jvegaf/Vumeter/README.md

# Vumeter

More info <a href="https://www.rinconingenieril.es/vumetro-por-etapas/"> https://www.rinconingenieril.es/vumetro-por-etapas/ </a>
