jvegaf/Vumeter/doc/Ingeniería/Ingeniería.odt

Display driver – Configuración

El uso del LM3915 exige el cálculo de dos resistencias encargadas de fijar la tensión de referencia del driver. La tensión de referencia controla la corriente de salida de cada canal (cada LED) y la tensión de referencia superior del driver.

El objetivo, no superar 15mA por canal y 3v de referencia. Se considera el uso de dos resistencias con valores: R_1 = 1 K %OMEGA y R_2 = 1 K %OMEGA

Según el fabricante y debido a la fuente de tensión constante de 1,25 v del circuito integrado, la tensión de referencia es:

V_REF = 1,25 \( 1 + {R_2} over {R_1} \) + R_2 · 80 %mu A V_REF = 2,58v

La corriente de cada canal es función de la tensión de referencia de la siguiente manera:

I_LED = {12,5} over {R_1} + {V_REF} over {2200}

Por tanto la corriente constante por canal es de 13,67 mA.

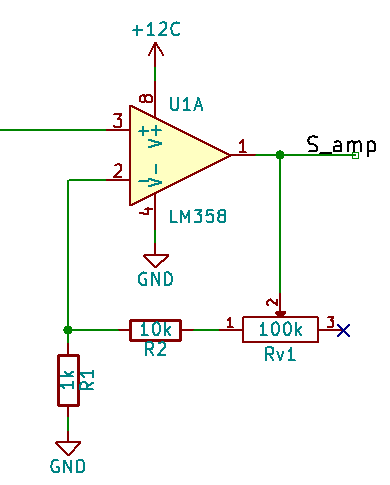
[picture p1: figure]

Amplificación

Debido a que la tensión de la señal de entrada puede ser desconocida, se procede a implementar una etapa de amplificación. Se decide usar el integrado LM358 por usar alimentación simple y contener dos amplificadores en el mismo encapsulado.

Considerando tensiones de pico de entrada comprendidas entre 25mV y 250mV y salida de Vref = 2,58 , la ganancia del amplificador no inversor deberá estar comprendida entre

G_max = {V_out} over {V rsup{min} rsub{i}} = { 2,58 } over { 0,025 } = 103,2

G_min = {V_out} over {V rsup{max} rsub{i}} = { 2,58 } over { 0,25 } = 10,32

Considerando la relación de ganancia de un amplificador en configuración no inversora, se fijan los valores de las resistencias R1, R2 y del potenciómetro Rv1.

G = 1 + {R_2 + Rv_1} over {R_1} R_1 = 1k %OMEGA R_2 = 10k %OMEGA Rv_1 = 100k %OMEGA

Filtrado de señal

Al tratarse de un dispositivo que representa de manera visual una señal de audio, se decide introducir la posibilidad de poder visualizar solo una zona del espectro audible (20 Hz a 20 Khz). Para esta tarea se decide establecer un sistema de filtros en cascada lo más sencillo posible, es por esto que se desarrollan dos filtros, un paso altos y un paso bajos y en arquitectura RC de primer orden.

Originalmente se plantean configurar los filtros en las frecuencias de paso de 200 Hz y 2KHz.

Para el filtro de 200 Hz se considera el uso de un condensador de poliéster de 100 nF (raster para PCB de 5mm):

F_c = { 1 } over { 2 %pi R C } R = { 1 } over { 2 %pi F_c C } = 6216 %OMEGA

El valor comercial más cercano es de R = 6k2 ohm. Este valor comercial de resistencia mueve la frecuencia de paso a 256,7 Hz.

Para el filtro de 2 KHz se considera el uso de un condensador de poliester de 10nF (raster para PCB de 5mm):

R = { 1 } over { 2 %pi F_c C } = 7957 %OMEGA

El valor comercial más cercano es 8k2 ohm. Este valor comercial de resistencia mueve la frecuencia de paso a 1940 Hz.

Se plantea la posibilidad de poner ambos filtros en la siguiente configuración ya que no se usarán los dos al mismo tiempo. La PCB se diseña para poder implementar cualquiera de los dos. En caso de no implementase el paso bajos, se deberá cortocircuitar los terminales de la resistencia R4. En caso de no implementarse el filtro paso altos, se deberá cortocircuitar el condensador C1.

Al final de la etapa de filtrado se encuentra el segundo amplificador operacional del LM358 en configuración buffer para evitar posibles efectos de carga.

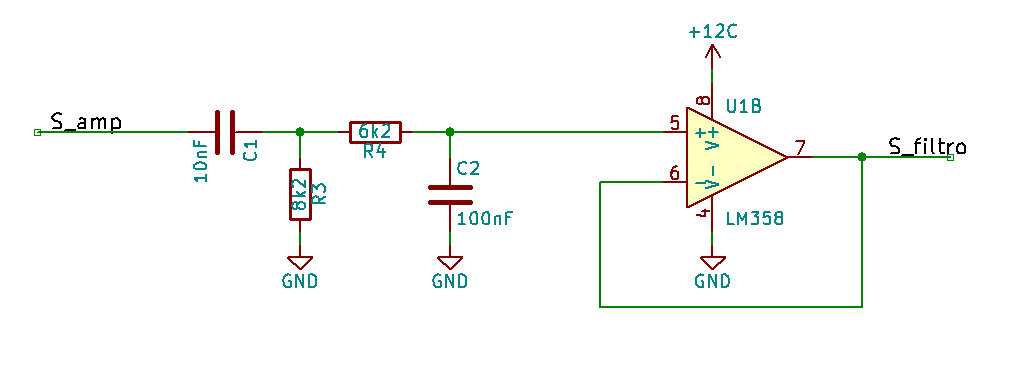
[picture p2: figure]

LED indicador de encendido

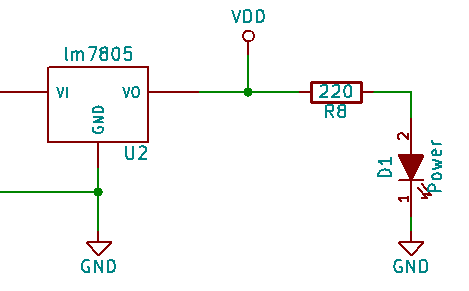
[picture p3: figure]

En la placa de circuito impreso se encuentra la posibilidad de colocar el LED D1 y la resistencia R8 para indicar el estado de energía del circuito.

El LED se alimenta desde el regulador de tensión con salida fija a 5v (lm7805). Debido a que la tensión del LED es de 1,8 v y su corriente de 15 mA se hace necesario colocar una resistencia R8.

R_8 = {V_DD - V_F} over {I_LED} = { 5 - 1,8 } over { 15 mA } = 213 %OMEGA

El valor comercial más cercano es R8 = 220 Ω lo que genera una corriente de 14,55 mA.

www.rinconingenieril.es hola@rinconingenieril.es 3
