jvegaf/Vumeter/doc/Ingeniería/Recursos/LED.PNG

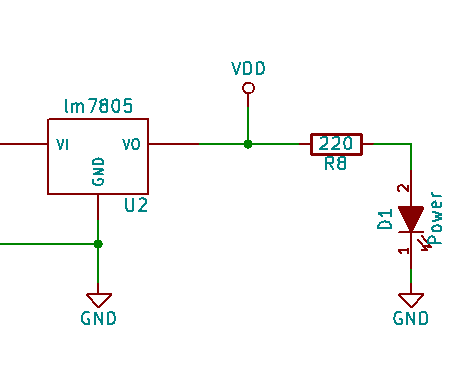
doc/Ingeniería/Recursos/LED.PNG
