jvegaf/Vumeter/3d/Base.FCStd

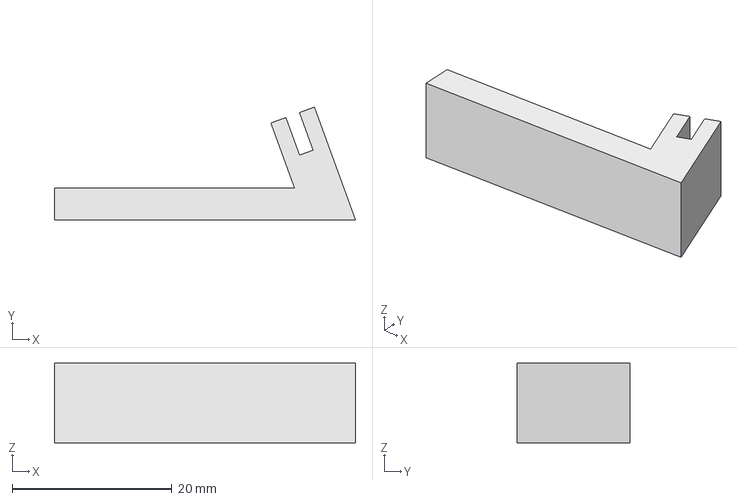
[picture p5: CAD file, 2017-09-30]
3d/Base.FCStd
37.6 x 14.1 x 10.0 mm
