jvegaf/Vumeter/3d/Base_ancha.FCStd

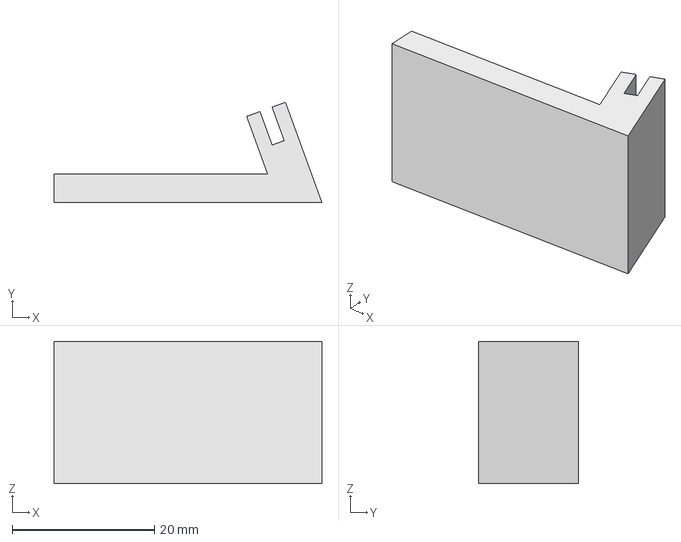
[picture p6: CAD file, 2017-09-30]
3d/Base_ancha.FCStd
37.6 x 14.1 x 20.0 mm
