jvegaf/Vumeter/3d/strip.FCStd

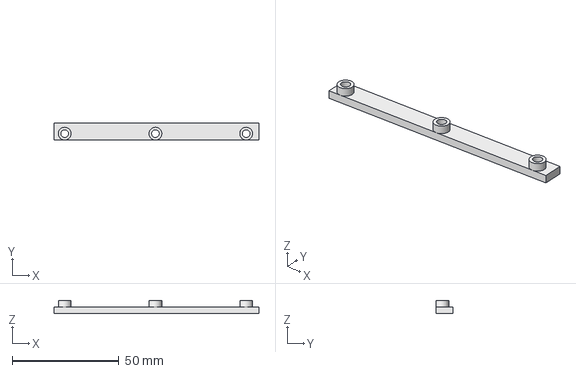
[picture p7: CAD file, 2017-09-30]
3d/strip.FCStd
96.0 x 8.00 x 6.00 mm
