jvegaf/Vumeter/(list of files, cad)

Other CAD files:
3d/base.stl
3d/base_ancha.stl
3d/strip.stl
