jvegaf/Vumeter/doc/schematics/vumeter.pdf

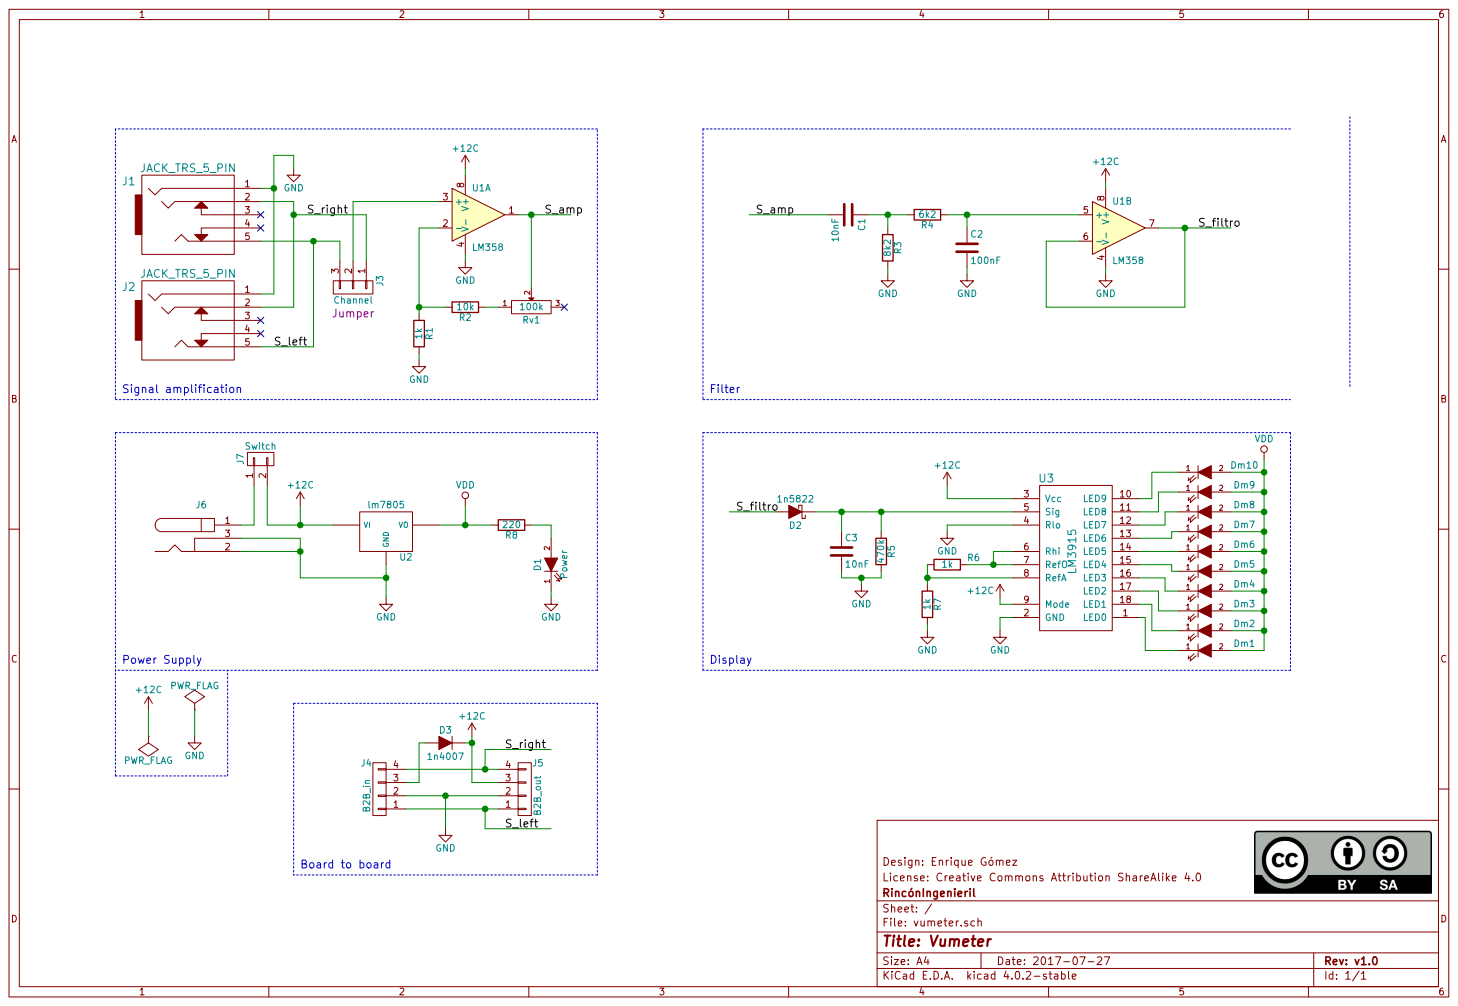
[picture p8: page 1]

1 J3 Channel Jumper GND 1kR1 GND
S_right

VDD

PWR_FLAG | PWR_FLAG

Id: 1/1 Title: Vumeter File: vumeter.sch Sheet: / RincónIngenieril License: Creative Commons Attribution ShareAlike 4.0 Design: Enrique Gómez
