jvegaf/Vumeter/doc/PCB/PDF/vumeter-B.Cu.pdf

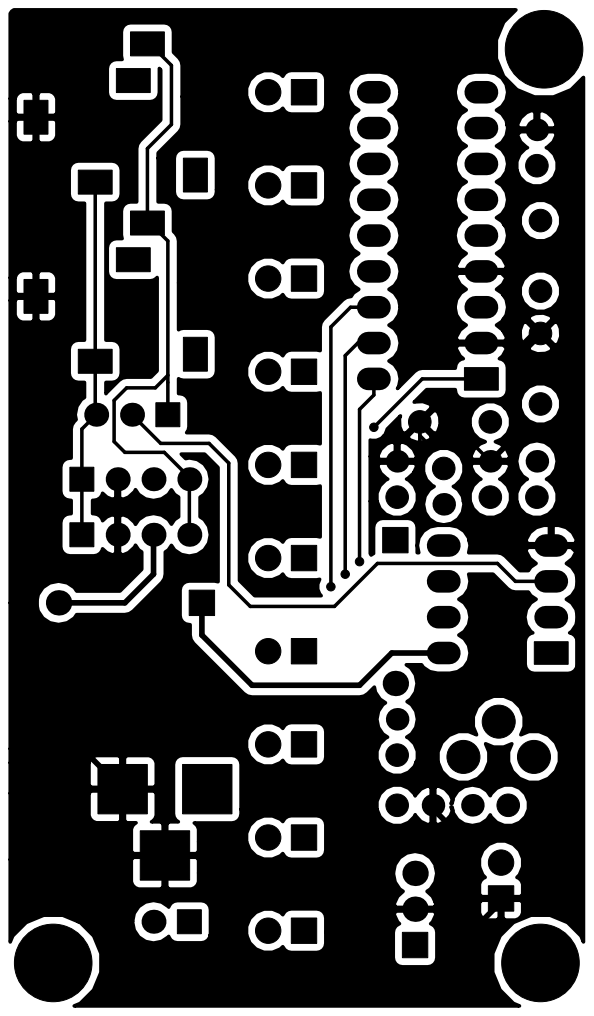
[picture p9: page 1]
