jvegaf/Vumeter/doc/PCB/PDF/vumeter-B.Mask.pdf

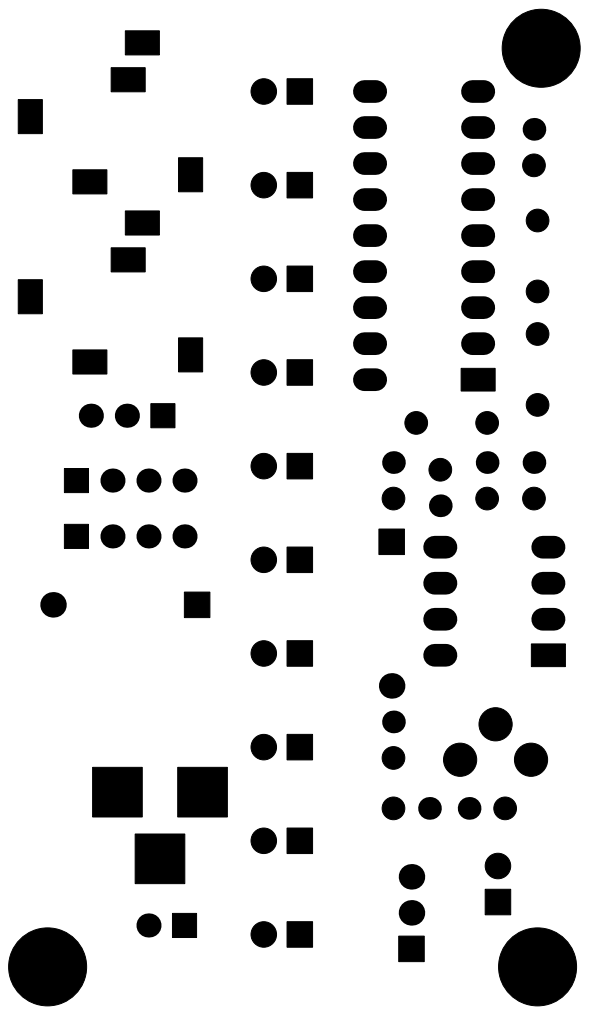
[picture p10: page 1]
