jvegaf/Vumeter/doc/PCB/PDF/vumeter-Edge.Cuts.pdf

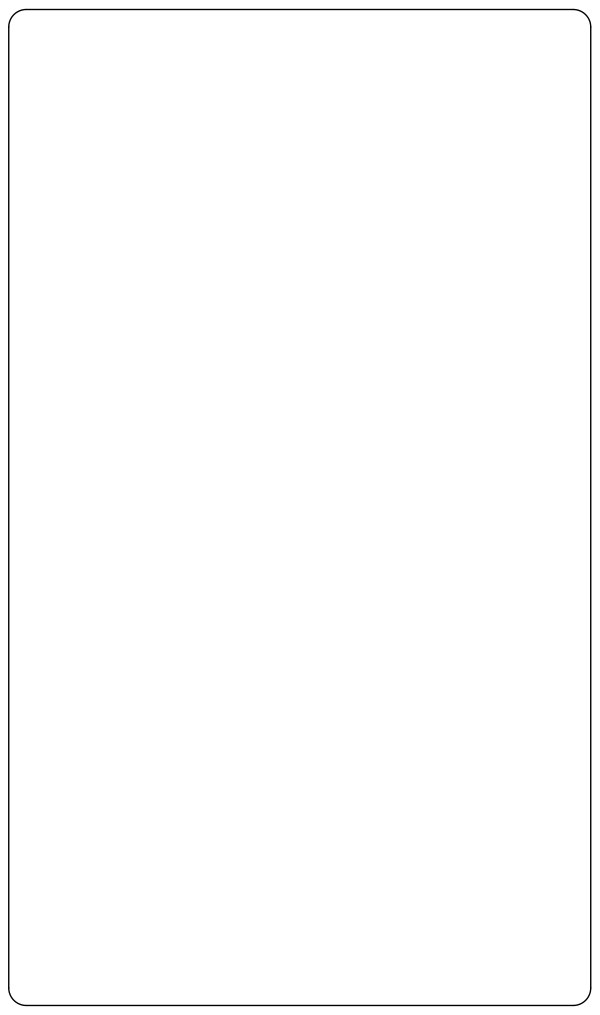
[picture p11: page 1]
