jvegaf/Vumeter/doc/PCB/PDF/vumeter-F.Cu.pdf

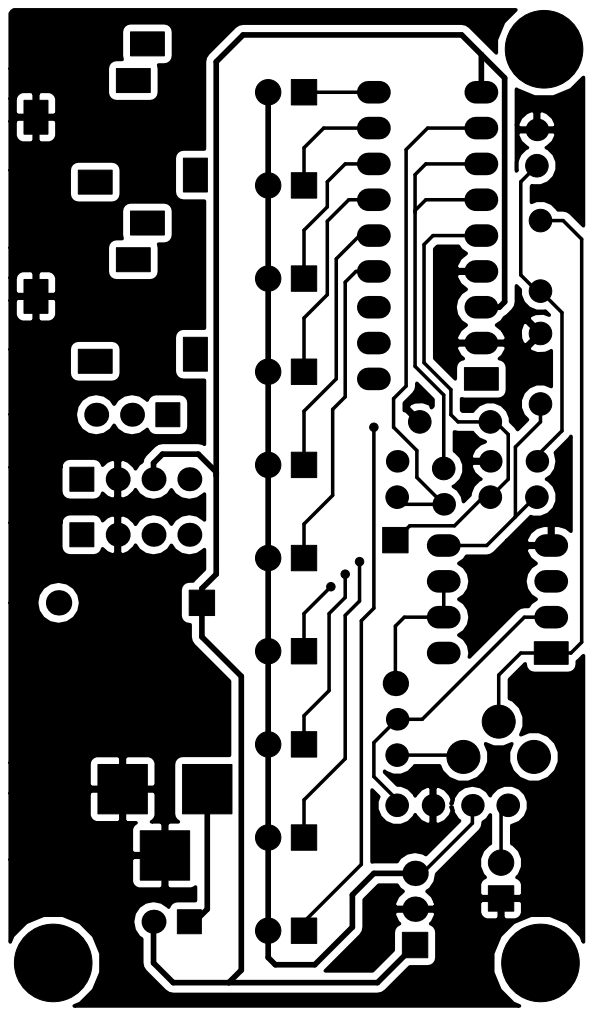
[picture p12: page 1]
