jvegaf/Vumeter/doc/PCB/PDF/vumeter-F.SilkS.pdf

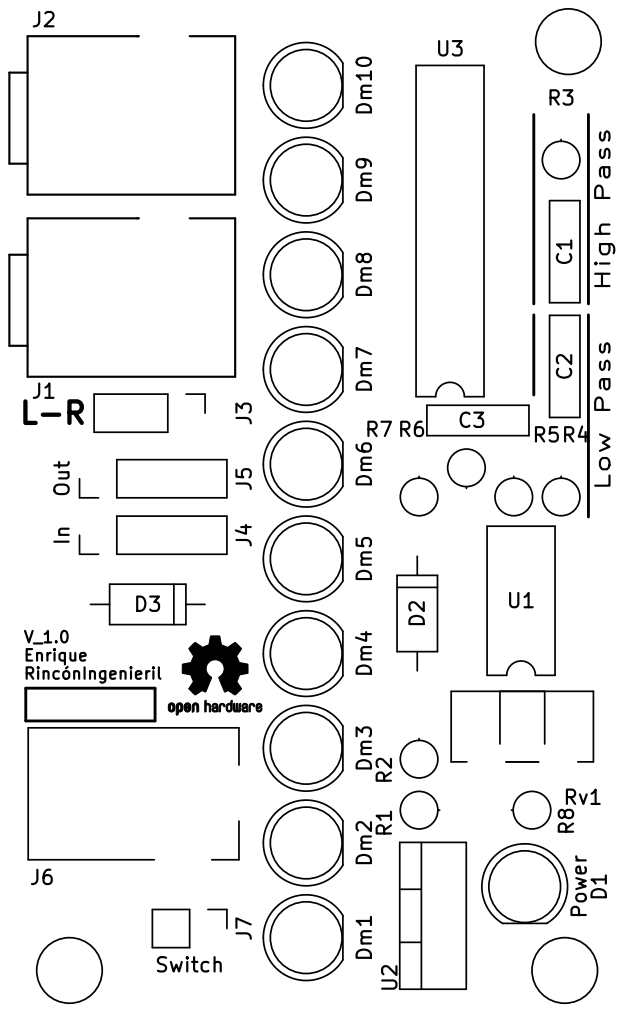
[picture p13: page 1]
