jvegaf/Vumeter/src-kicad/vumeter.kicad_pcb

## KiCad design src-kicad/vumeter.kicad_pcb (2017-09-19)

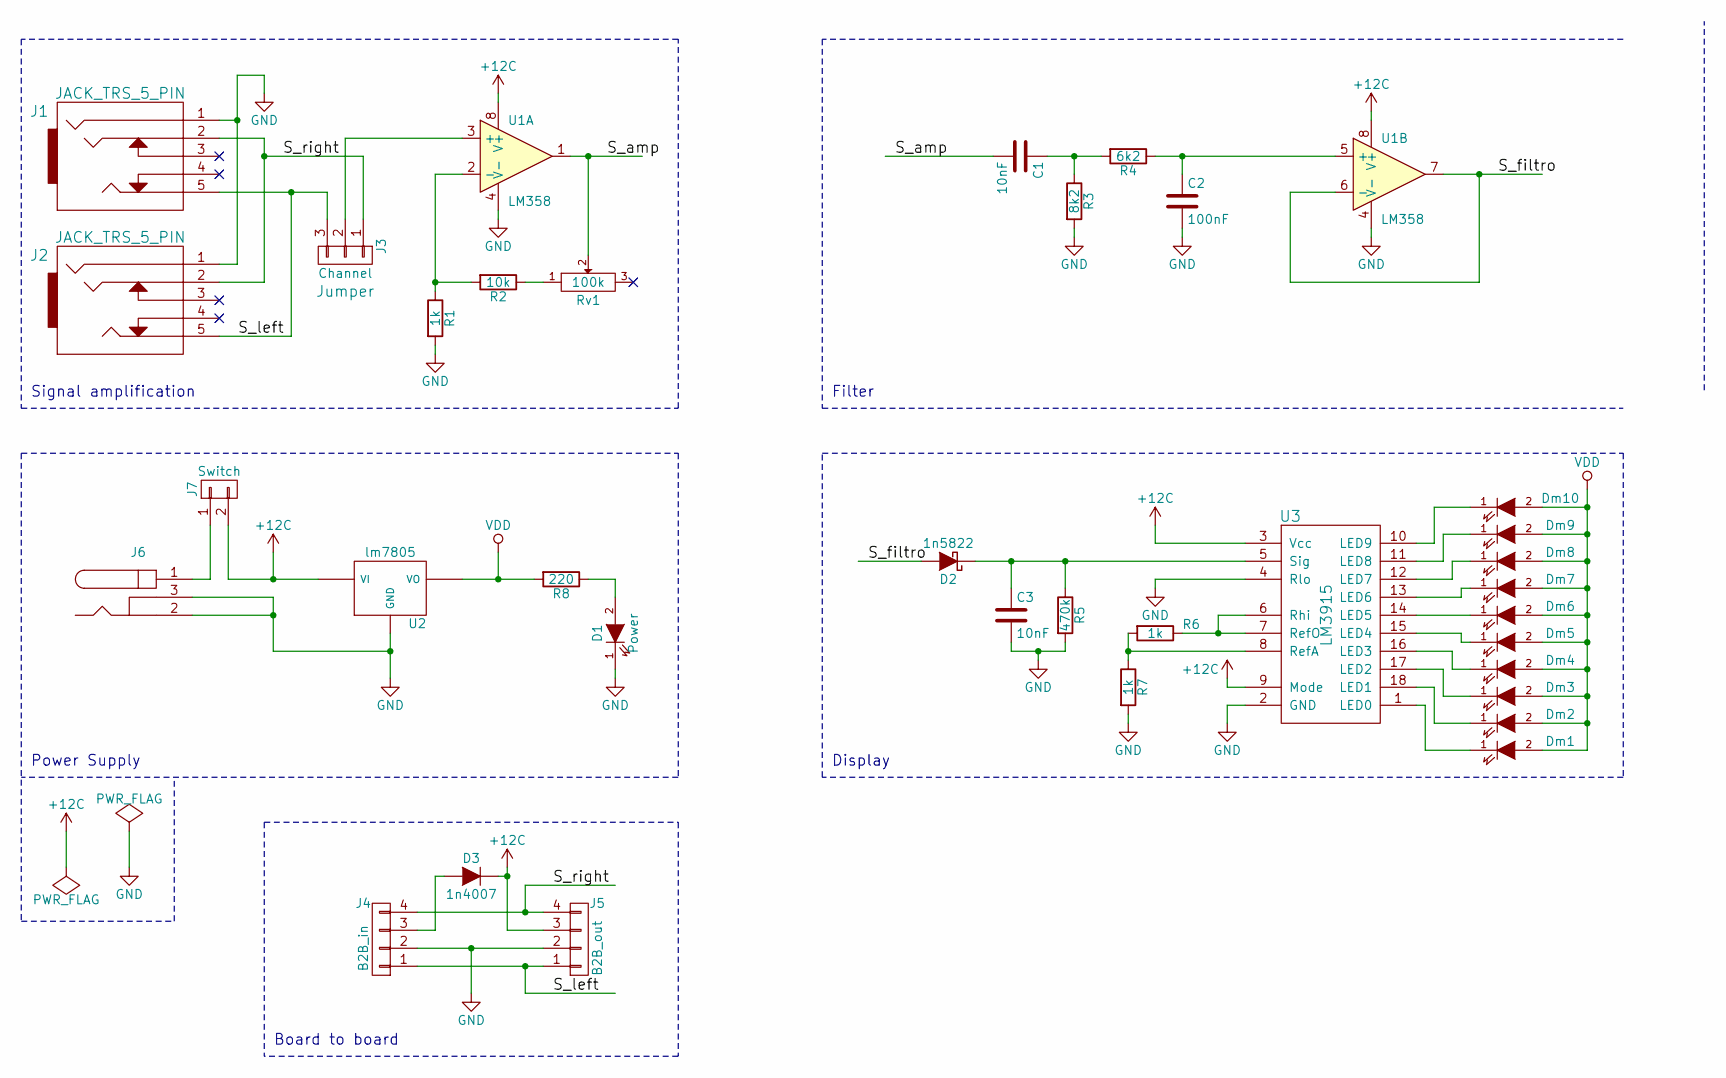
[picture p14: schematic vumeter.sch]

Parts:
1n4007: D3; D_A-405_P10.16mm_Horizontal
C1, C3: 10nF; C_Rect_L7.0mm_W2.0mm_P5.00mm
C2: 100nF; C_Rect_L7.0mm_W2.0mm_P5.00mm
D1: Power; LED_D5.0mm
D2: 1n5822; D_A-405_P10.16mm_Horizontal
Dm1, Dm2, Dm3, Dm4, Dm5, Dm6, Dm7, Dm8, Dm9, Dm10: LED; LED_D5.0mm
J1, J2: JACK_TRS_5_PIN; Jack_TRS_3.5mm_5_pin
J3: Channel; Pin_Header_Straight_1x03_Pitch2.54mm
J4: B2B_in; Pin_Header_Straight_1x04_Pitch2.54mm
J5: B2B_out; Pin_Header_Straight_1x04_Pitch2.54mm
J6: BARREL_JACK
J7: Switch; Pin_Header_Straight_1x02_Pitch2.54mm
R1, R6, R7: 1k; R_Axial_DIN0207_L6.3mm_D2.5mm_P2.54mm_Vertical
R2: 10k; R_Axial_DIN0207_L6.3mm_D2.5mm_P2.54mm_Vertical
R3: 8k2; R_Axial_DIN0207_L6.3mm_D2.5mm_P2.54mm_Vertical
R4: 6k2; R_Axial_DIN0207_L6.3mm_D2.5mm_P2.54mm_Vertical
R5: 470k; R_Axial_DIN0207_L6.3mm_D2.5mm_P2.54mm_Vertical
R8: 220; R_Axial_DIN0207_L6.3mm_D2.5mm_P2.54mm_Vertical
Rv1: 100k; Potentiometer_Trimmer_ACP_CA9h2.5_Vertical_Px2.5mm_Py5.0mm
U1: LM358; DIP-8_W7.62mm_LongPads
U2: lm7805; TO-220_Vertical
U3: LM3915; DIP-18_W7.62mm_LongPads

Connections:
+12C: 1n4007.1 (K), J5.3, J7.2, U1.8 (V+), U2.1 (VI), U3.3 (Vcc), U3.9 (Mode)
/S_amp: C1.2, Rv1.2, U1.1
/S_filtro: D2.2 (A), U1.6 (-), U1.7
/S_left: J1.5, J2.5, J3.3, J4.1, J5.1
/S_right: J1.2, J2.2, J3.1, J4.4, J5.4
GND: C2.2, C3.2, D1.1 (K), J1.1, J2.1, J4.2, J5.2, J6.2, J6.3, R1.2, R3.2, R5.2, R7.2, U1.4 (V-), U2.2 (GND), U3.2 (GND), U3.4 (Rlo)
unnamed: 1n4007.2 (A), J4.3
unnamed: C1.1, R3.1, R4.2
unnamed: C2.1, R4.1, U1.5 (+)
unnamed: C3.1, D2.1 (K), R5.1, U3.5 (Sig)
unnamed: D1.2 (A), R8.1
unnamed: Dm1.1 (K), U3.1 (LED0)
unnamed: Dm2.1 (K), U3.18 (LED1)
unnamed: Dm3.1 (K), U3.17 (LED2)
unnamed: Dm4.1 (K), U3.16 (LED3)
unnamed: Dm5.1 (K), U3.15 (LED4)
unnamed: Dm6.1 (K), U3.14 (LED5)
unnamed: Dm7.1 (K), U3.13 (LED6)
unnamed: Dm8.1 (K), U3.12 (LED7)
unnamed: Dm9.1 (K), U3.11 (LED8)
unnamed: Dm10.1 (K), U3.10 (LED9)
unnamed: J3.2, U1.3 (+)
unnamed: J6.1, J7.1
unnamed: R1.1, R2.2, U1.2 (-)
unnamed: R2.1, Rv1.1
unnamed: R6.1, U3.6 (Rhi), U3.7 (RefO)
unnamed: R6.2, R7.1, U3.8 (RefA)
VDD: Dm1.2 (A), Dm2.2 (A), Dm3.2 (A), Dm4.2 (A), Dm5.2 (A), Dm6.2 (A), Dm7.2 (A), Dm8.2 (A), Dm9.2 (A), Dm10.2 (A), R8.2, U2.3 (VO)

Notes on the sheet:
Power Supply
Signal amplification
Filter
Display
Board to board

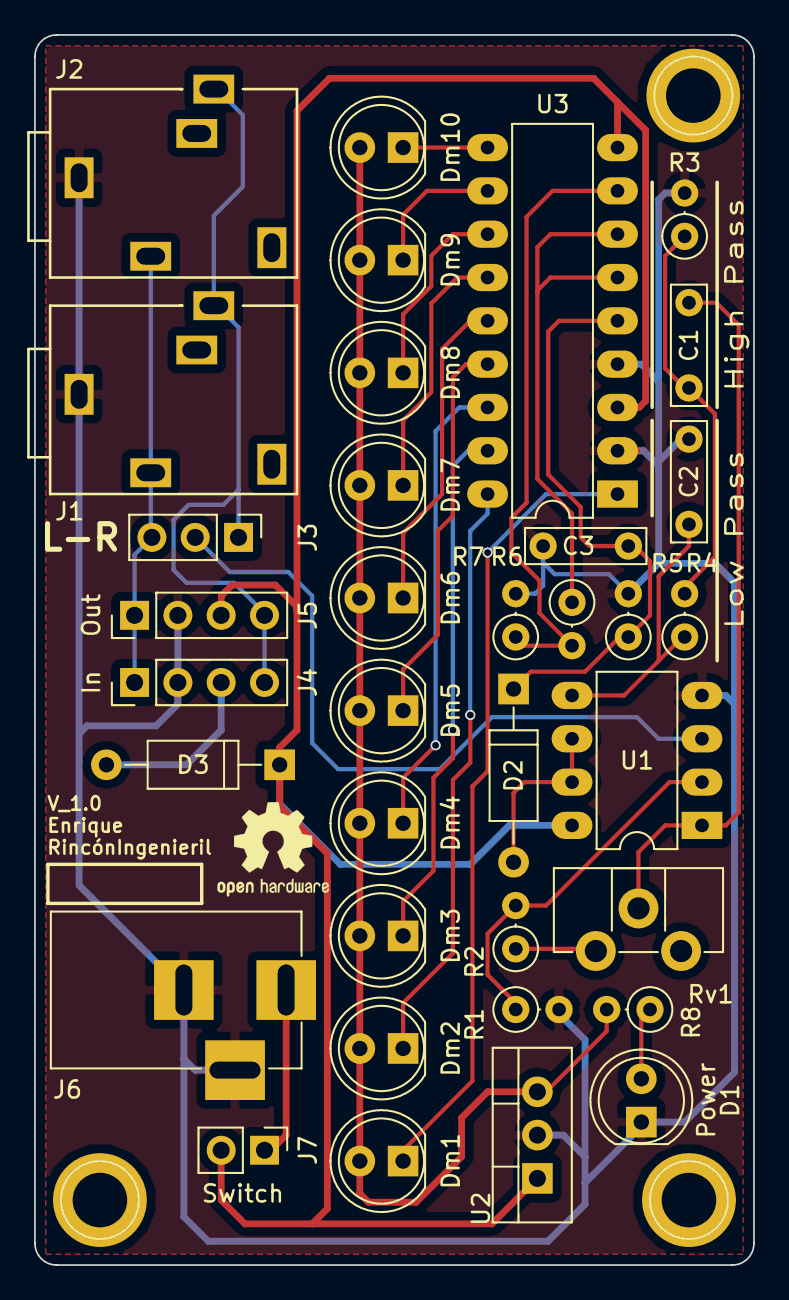
[picture p15: board vumeter.kicad_pcb from above]

Board: 2 copper layers, 42.2 x 72.1 mm, 35 parts (0 on the bottom side), 28 nets.
