jvegaf/Vumeter/(commit log)

2017-09-30 3d update
    [Base.FCStd, Base_1.FCStd, Base_2.FCStd, Base_2_larga.FCStd, Base_ancha.FCStd, base.stl, base_2.stl, base_2_larga.stl]
2017-11-24 schematic modified now analyze stereo signal without lowpass and hipass filters.
    [vumeter.sch]
